PRIM-EDV/trx-tracker/parts/parts.xlsx

Part | Quantity | Price
E22900M30S | 1 | 10.87 €
