PRIM-EDV/trx-tracker/eagle/trx-breakout.brd

## EAGLE design eagle/trx-breakout.brd (2024-02-08)

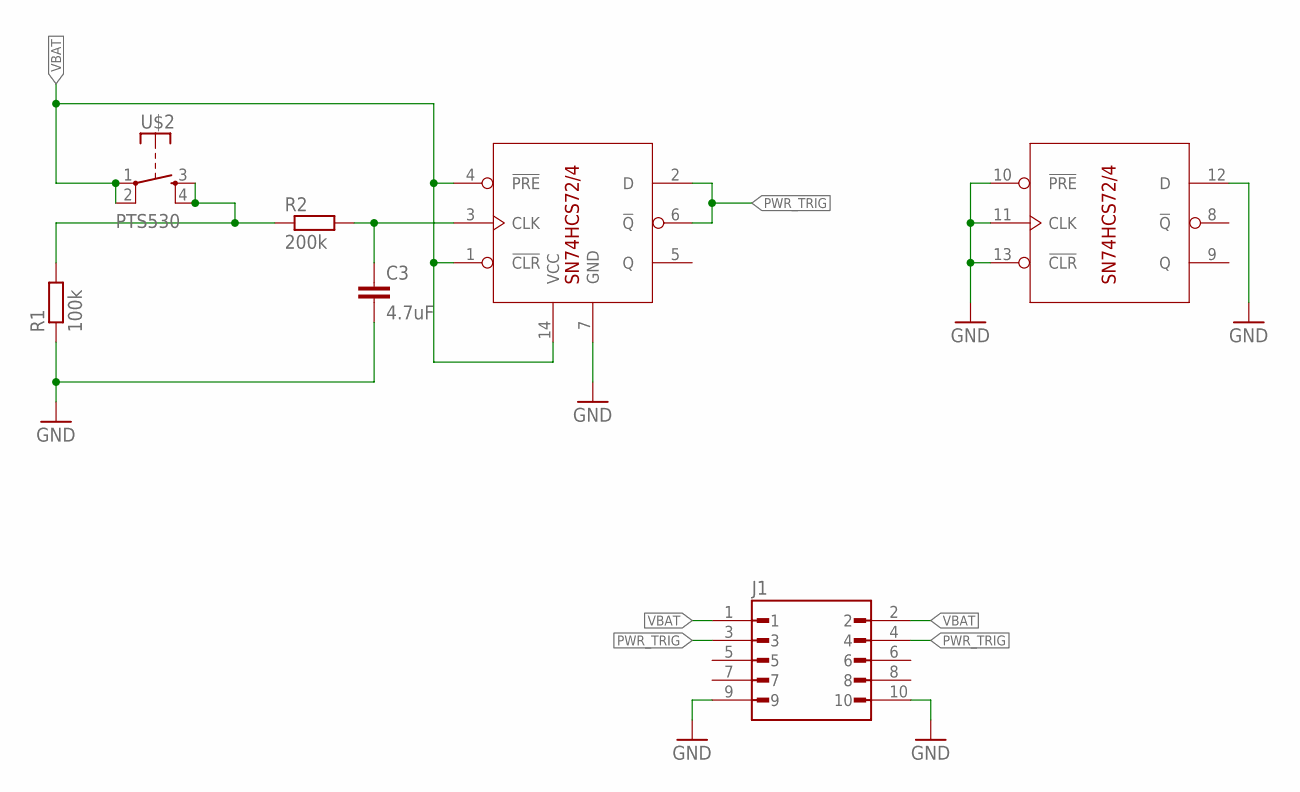
[picture p1: schematic trx-breakout.sch]

Parts:
C3: 4.7uF; C0805
J1: DF12NB(3.0)-10DX-0.5VHRS_DF12NB(3.0)-10DS-0.5V; HRS_DF12NB(3.0)-10DS-0.5V
R1: 100k; R0805
R2: 200k; R0805
U$1: SN74HCS72/4; TSSOP14
U$2: PTS530

Connections:
GND: C3.2, J1.9, J1.10, R1.1, U$1.7 (GND), U$1.10 (!PRE), U$1.11 (CLK), U$1.12 (D), U$1.13 (!CLR)
unnamed: C3.1, R2.2, U$1.3 (CLK)
unnamed: R1.2, R2.1, U$2.3 (S), U$2.4 (S)
PWR_TRIG: J1.3, J1.4, U$1.2 (D), U$1.6 (!Q)
VBAT: J1.1, J1.2, U$1.1 (!CLR), U$1.4 (!PRE), U$1.14 (VCC), U$2.1, U$2.2

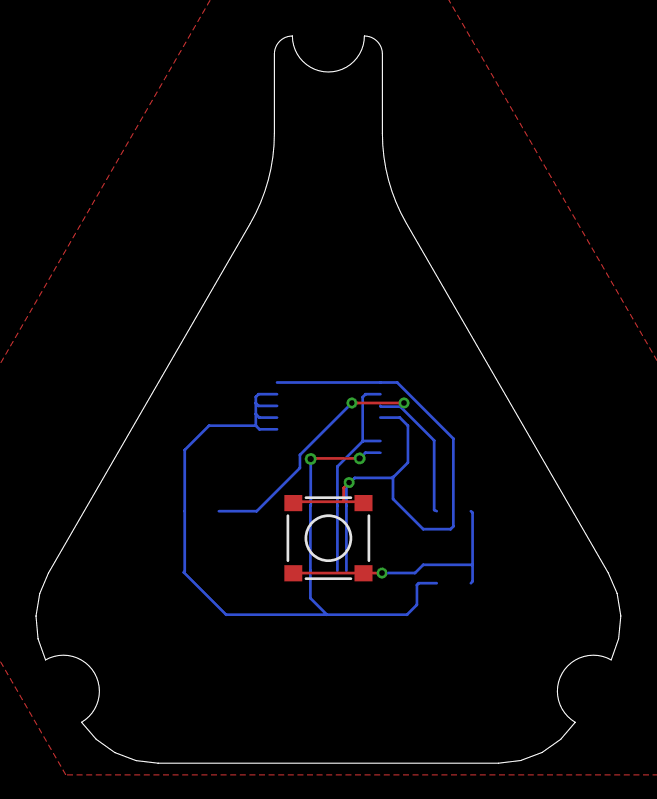
[picture p2: board trx-breakout.brd from above]

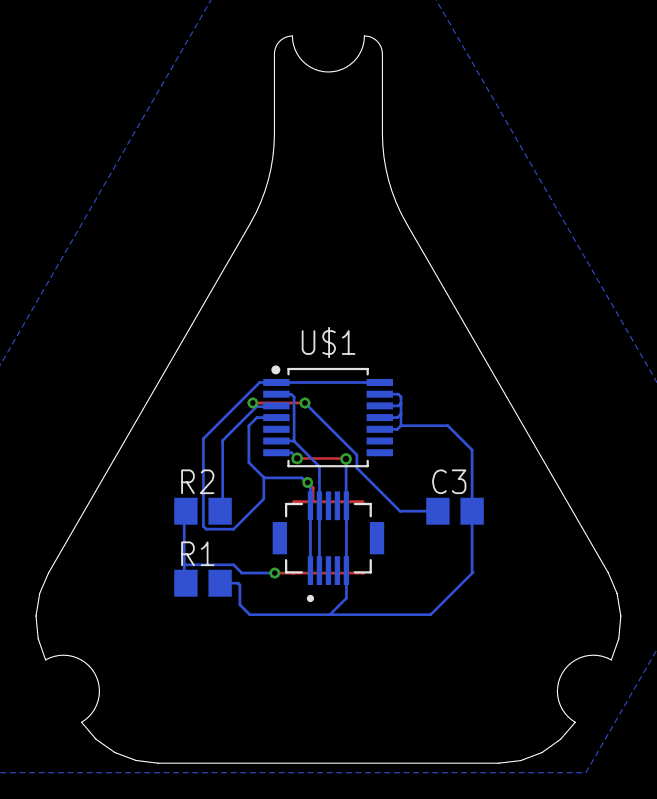
[picture p3: board trx-breakout.brd from below]

Board: 2 copper layers, 32.5 x 40.4 mm, 6 parts (5 on the bottom side), 5 nets.
