PRIM-EDV/trx-tracker/eagle/trx-mainboard.brd

## EAGLE design eagle/trx-mainboard.brd (2024-02-08)

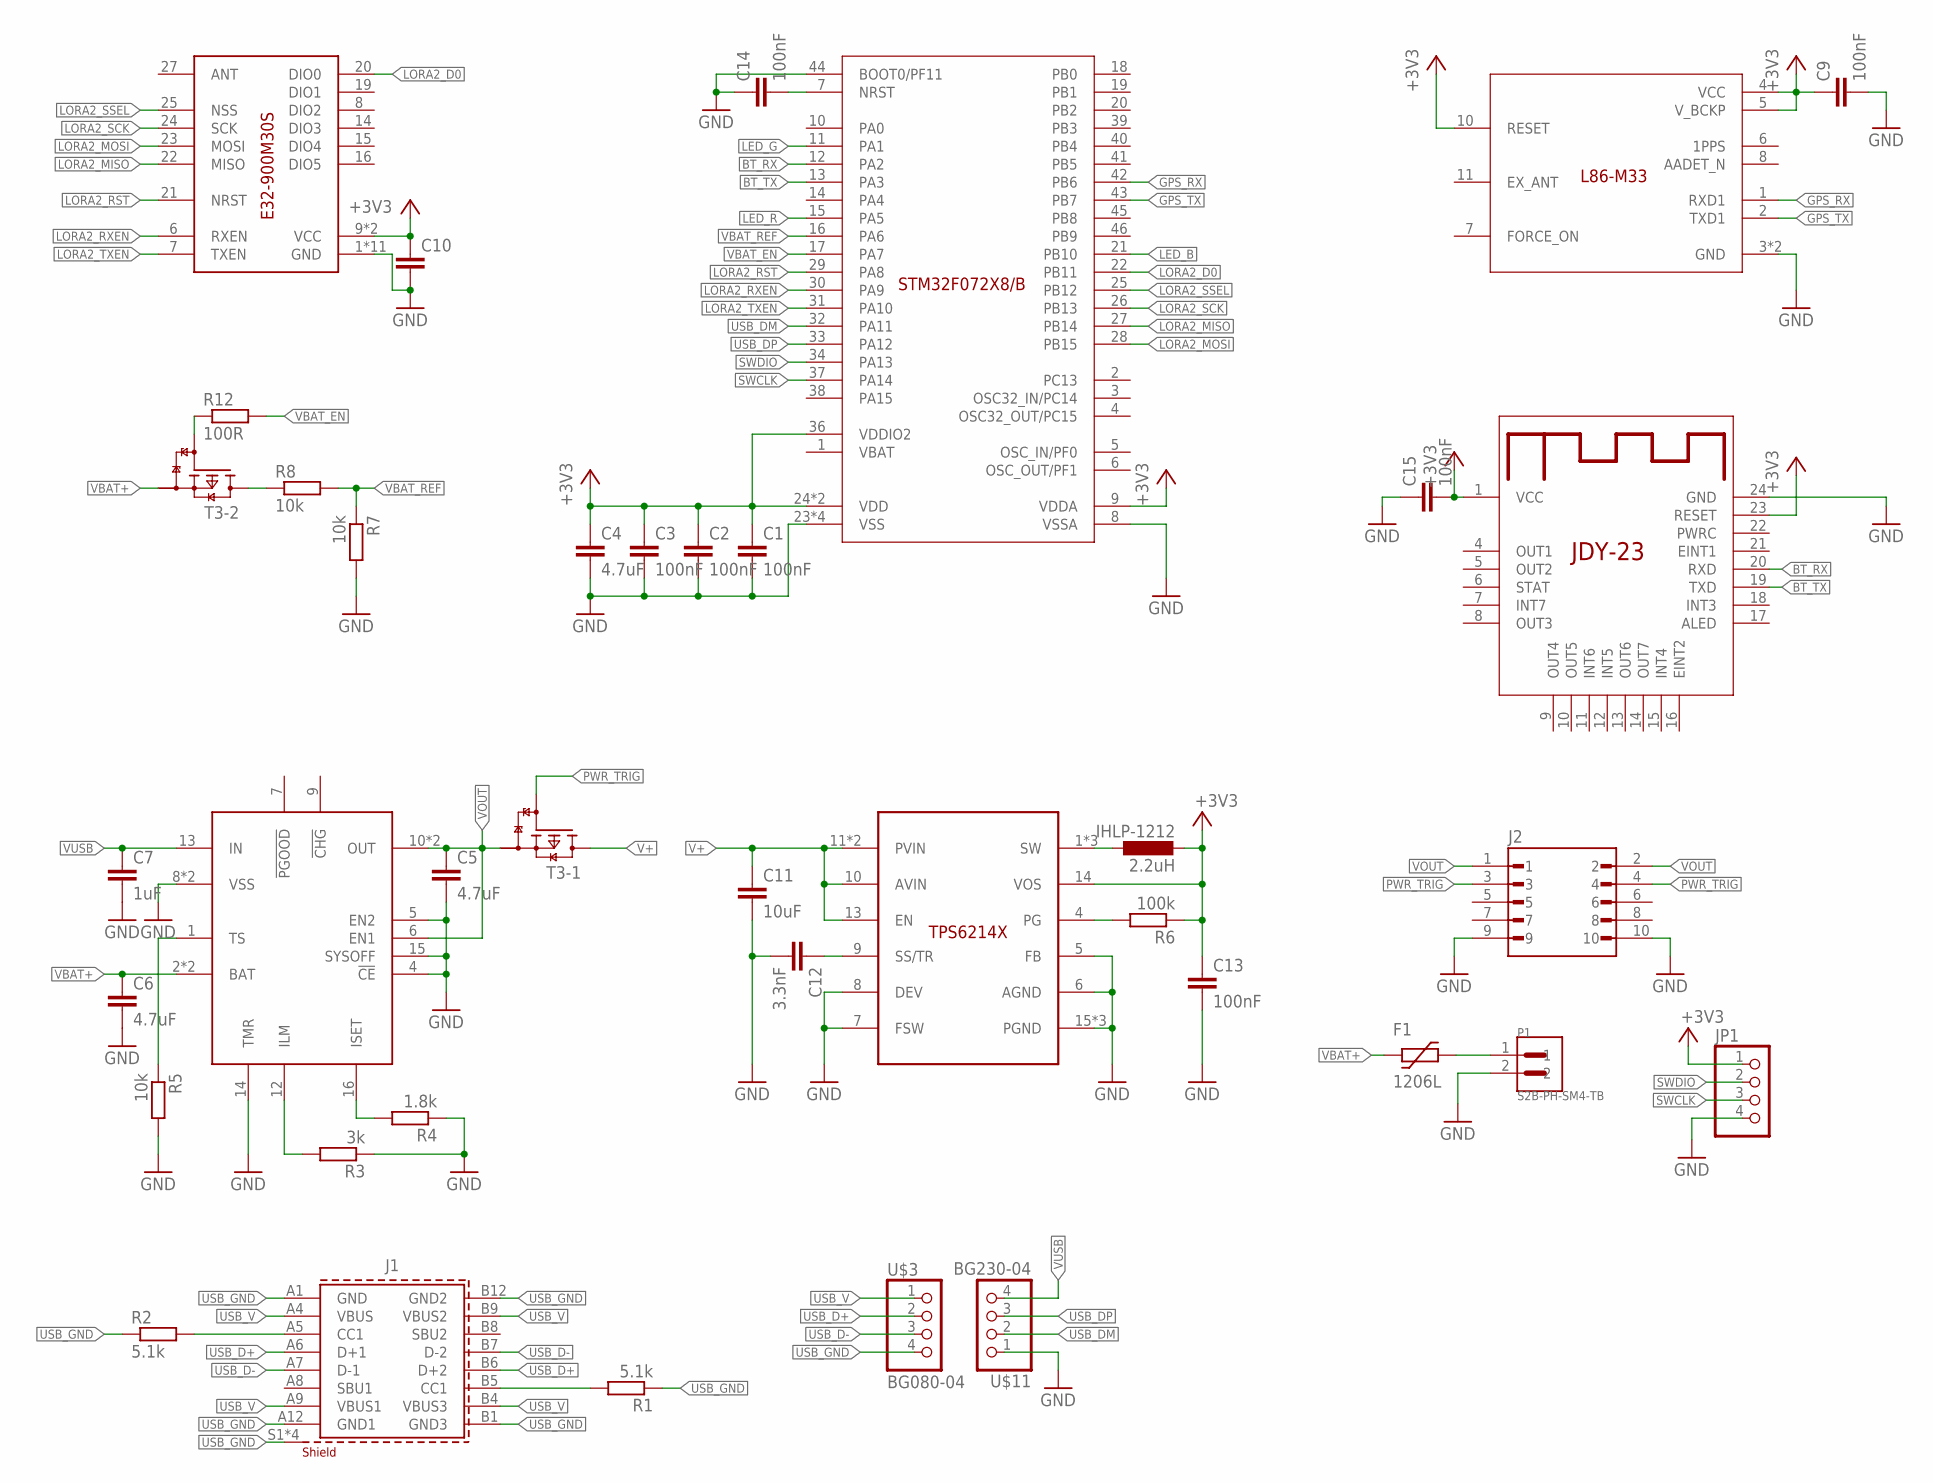
[picture p4: schematic trx-mainboard.sch, sheet 1, Logic]

Parts:
C1, C2, C3, C9, C13, C14, C15: 100nF; C0805
C4, C5, C6, C10: 4.7uF; C0805
C7: 1uF; C0805
C11: 10uF; C0805
C12: 3.3nF; C0805
F1: 1206L
J1: 629722000214
J2: DF12NB(3.0)-10DP-0.5V; HRS_DF12NB(3.0)-10DP-0.5V
JP1: PINHD-1X04_2.54-SMD; 1X04SMD
P1: S2B-PH-SM4-TB; JST_S2B-PH-SM4-TB
R1, R2: 5.1k; R0805
R3: 3k; R0805
R4: 1.8k; R0805
R5, R7, R8: 10k; R0805
R6: 100k; R0805
R12: 100R; R0805
T3: NX3008PBKS; SOT363
U2: BQ2407X; VQFN16-3X3
U$1: L86-M33
U$2: TPS6214X; VQFN16-3X3
U$3: BG080-04; P-1X4/90-2.54X1.50MMX2.54MM-SMT
U$4: IHLP-1212; 1212BZ
U$5: JDY-23
U$10: STM32-F072X8/B-48; UFQFPN48-7X7
U$11: BG230-04; S-1X4/90-2.54MM-SMT
U$14: E32-900M30S

Connections:
+3V3: C1.1, C2.1, C3.1, C4.1, C9.1, C10.1, C13.1, C15.2, JP1.1, R6.1, U$1.4 (VCC), U$1.5 (V_BCKP), U$1.10 (RESET), U$2.14 (VOS), U$4.2, U$5.1 (VCC), U$5.23 (RESET), U$10.9 (VDDA), U$10.24 (VDD), U$10.36 (VDDIO2), U$10.48 (VDD), U$14.9 (VCC), U$14.10 (VCC); also elsewhere on the board
BT_RX: U$5.20 (RXD), U$10.12 (PA2)
BT_TX: U$5.19 (TXD), U$10.13 (PA3)
GND: C1.2, C2.2, C3.2, C4.2, C5.2, C6.2, C7.2, C9.2, C10.2, C11.2, C12.2, C13.2, C14.1, C15.1, J2.9, J2.10, JP1.4, P1.2, R3.1, R4.1, R5.2, R7.2, U2.4 (!CE), U2.5 (EN2), U2.8 (VSS), U2.14 (TMR), U2.15 (SYSOFF), U2.17 (VSS), U$1.3 (GND), U$1.12 (GND), U$2.5 (FB), U$2.6 (AGND), U$2.7 (FSW), U$2.8 (DEV), U$2.15 (PGND), U$2.16 (PGND), U$2.17 (PGND), U$5.24 (GND), U$10.8 (VSSA), U$10.23 (VSS), U$10.35 (VSS), U$10.44 (BOOT0/PF11), U$10.47 (VSS), U$10.P$49 (VSS), U$11.1, U$14.1 (GND), U$14.2 (GND), U$14.3 (GND), U$14.4 (GND), U$14.5 (GND), U$14.11 (GND), U$14.12 (GND), U$14.17 (GND), U$14.18 (GND), U$14.26 (GND), U$14.28 (GND); also elsewhere on the board
GPS_RX: U$1.1 (RXD1), U$10.42 (PB6)
GPS_TX: U$1.2 (TXD1), U$10.43 (PB7)
LED_B: U$10.21 (PB10); also elsewhere on the board
LED_G: U$10.11 (PA1); also elsewhere on the board
LED_R: U$10.15 (PA5); also elsewhere on the board
LORA2_D0: U$10.22 (PB11), U$14.20 (DIO0)
LORA2_MISO: U$10.27 (PB14), U$14.22 (MISO)
LORA2_MOSI: U$10.28 (PB15), U$14.23 (MOSI)
LORA2_RST: U$10.29 (PA8), U$14.21 (NRST)
LORA2_RXEN: U$10.30 (PA9), U$14.6 (RXEN)
LORA2_SCK: U$10.26 (PB13), U$14.24 (SCK)
LORA2_SSEL: U$10.25 (PB12), U$14.25 (NSS)
LORA2_TXEN: U$10.31 (PA10), U$14.7 (TXEN)
unnamed: J1.A5 (CC1), R2.2
unnamed: J1.B5 (CC1), R1.2
unnamed: R3.2, U2.12 (ILM)
unnamed: R4.2, U2.16 (ISET)
unnamed: R5.1, U2.1 (TS)
unnamed: U$2.1 (SW), U$2.2 (SW), U$2.3 (SW), U$4.1
unnamed: C12.1, U$2.9 (SS/TR)
unnamed: R6.2, U$2.4 (PG)
unnamed: C14.2, U$10.7 (NRST)
unnamed: F1.P$2 (2), P1.1
unnamed: R8.1, T3.3 (D)
unnamed: R12.1, T3.5 (G)
PWR_TRIG: J2.3, J2.4, T3.2 (G)
SWCLK: JP1.3, U$10.37 (PA14)
SWDIO: JP1.2, U$10.34 (PA13)
USB_D+: J1.A6 (D+1), J1.B6 (D+2), U$3.2
USB_D-: J1.A7 (D-1), J1.B7 (D-2), U$3.3
USB_DM: U$10.32 (PA11), U$11.2
USB_DP: U$10.33 (PA12), U$11.3
USB_GND: J1.A1 (GND), J1.A12 (GND1), J1.B1 (GND3), J1.B12 (GND2), J1.S1 (SHIELD), J1.S2 (SHIELD), J1.S3 (SHIELD), J1.S4 (SHIELD), R1.1, R2.1, U$3.4
USB_V: J1.A4 (VBUS), J1.A9 (VBUS1), J1.B4 (VBUS3), J1.B9 (VBUS2), U$3.1
V+: C11.1, T3.6 (D), U$2.10 (AVIN), U$2.11 (PVIN), U$2.12 (PVIN), U$2.13 (EN)
VBAT+: C6.1, F1.P$1 (1), T3.4 (S), U2.2 (BAT), U2.3 (BAT)
VBAT_EN: R12.2, U$10.17 (PA7)
VBAT_REF: R7.1, R8.2, U$10.16 (PA6)
VOUT: C5.1, J2.1, J2.2, T3.1 (S), U2.6 (EN1), U2.10 (OUT), U2.11 (OUT)
VUSB: C7.1, U2.13 (IN), U$11.4

Notes on the sheet:
2.2uH

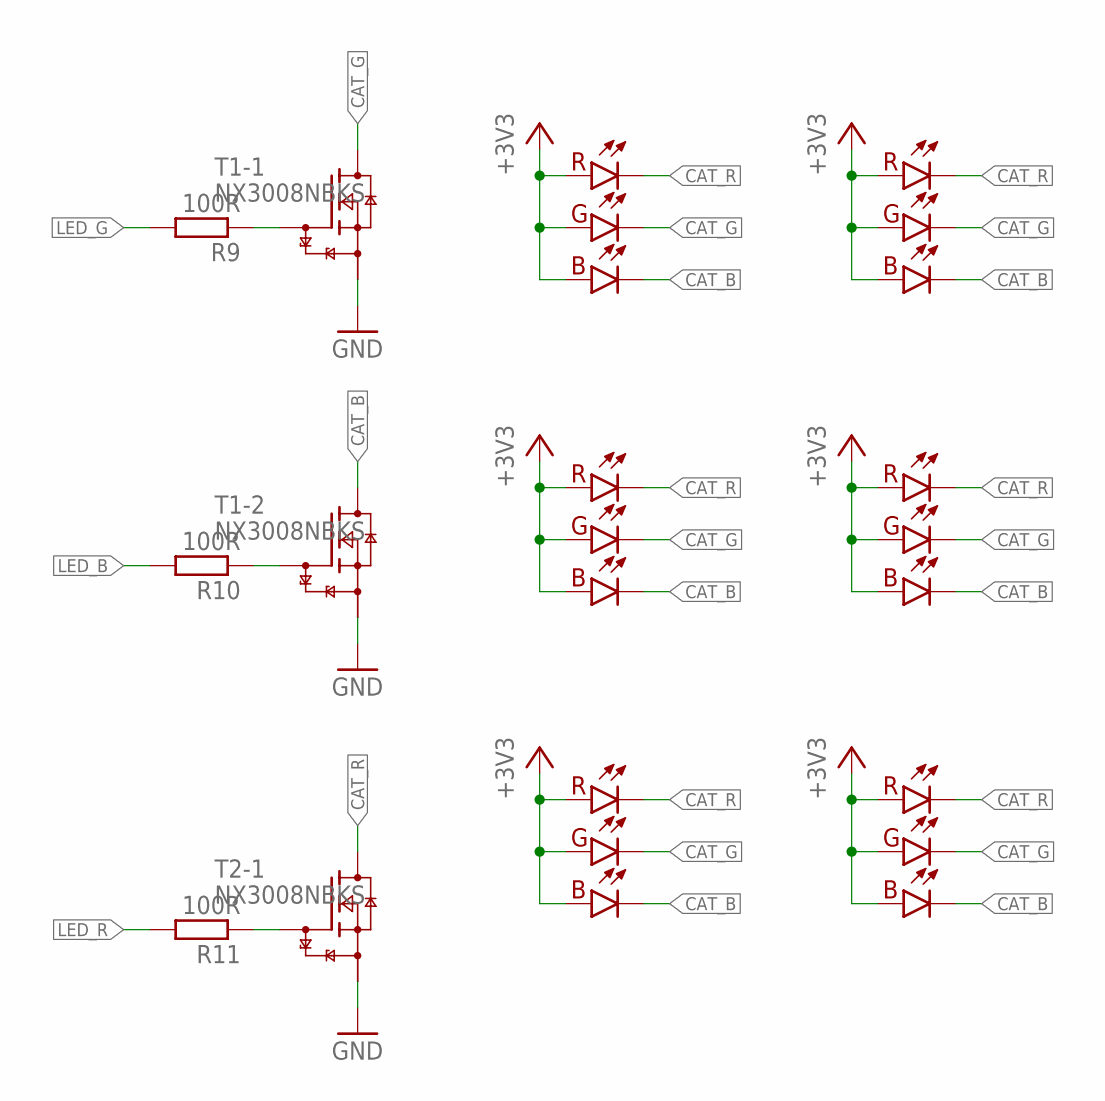
[picture p5: schematic trx-mainboard.sch, sheet 2]

Parts:
R9, R10, R11: 100R; R0805
T1, T2: NX3008NBKS; SOT363
U$6, U$7, U$8, U$9, U$12, U$13: RGB_LED; PLCC6

Connections:
+3V3: U$6.1 (A.B), U$6.3 (A.R), U$6.5 (A.G), U$7.1 (A.B), U$7.3 (A.R), U$7.5 (A.G), U$8.1 (A.B), U$8.3 (A.R), U$8.5 (A.G), U$9.1 (A.B), U$9.3 (A.R), U$9.5 (A.G), U$12.1 (A.B), U$12.3 (A.R), U$12.5 (A.G), U$13.1 (A.B), U$13.3 (A.R), U$13.5 (A.G); also elsewhere on the board
CAT_B: T1.3 (D), U$6.2 (C.B), U$7.2 (C.B), U$8.2 (C.B), U$9.2 (C.B), U$12.2 (C.B), U$13.2 (C.B)
CAT_G: T1.6 (D), U$6.6 (C.G), U$7.6 (C.G), U$8.6 (C.G), U$9.6 (C.G), U$12.6 (C.G), U$13.6 (C.G)
CAT_R: T2.6 (D), U$6.4 (C.R), U$7.4 (C.R), U$8.4 (C.R), U$9.4 (C.R), U$12.4 (C.R), U$13.4 (C.R)
GND: T1.1 (S), T1.4 (S), T2.1 (S); also elsewhere on the board
LED_B: R10.2; also elsewhere on the board
LED_G: R9.2; also elsewhere on the board
LED_R: R11.2; also elsewhere on the board
unnamed: R9.1, T1.2 (G)
unnamed: R10.1, T1.5 (G)
unnamed: R11.1, T2.2 (G)

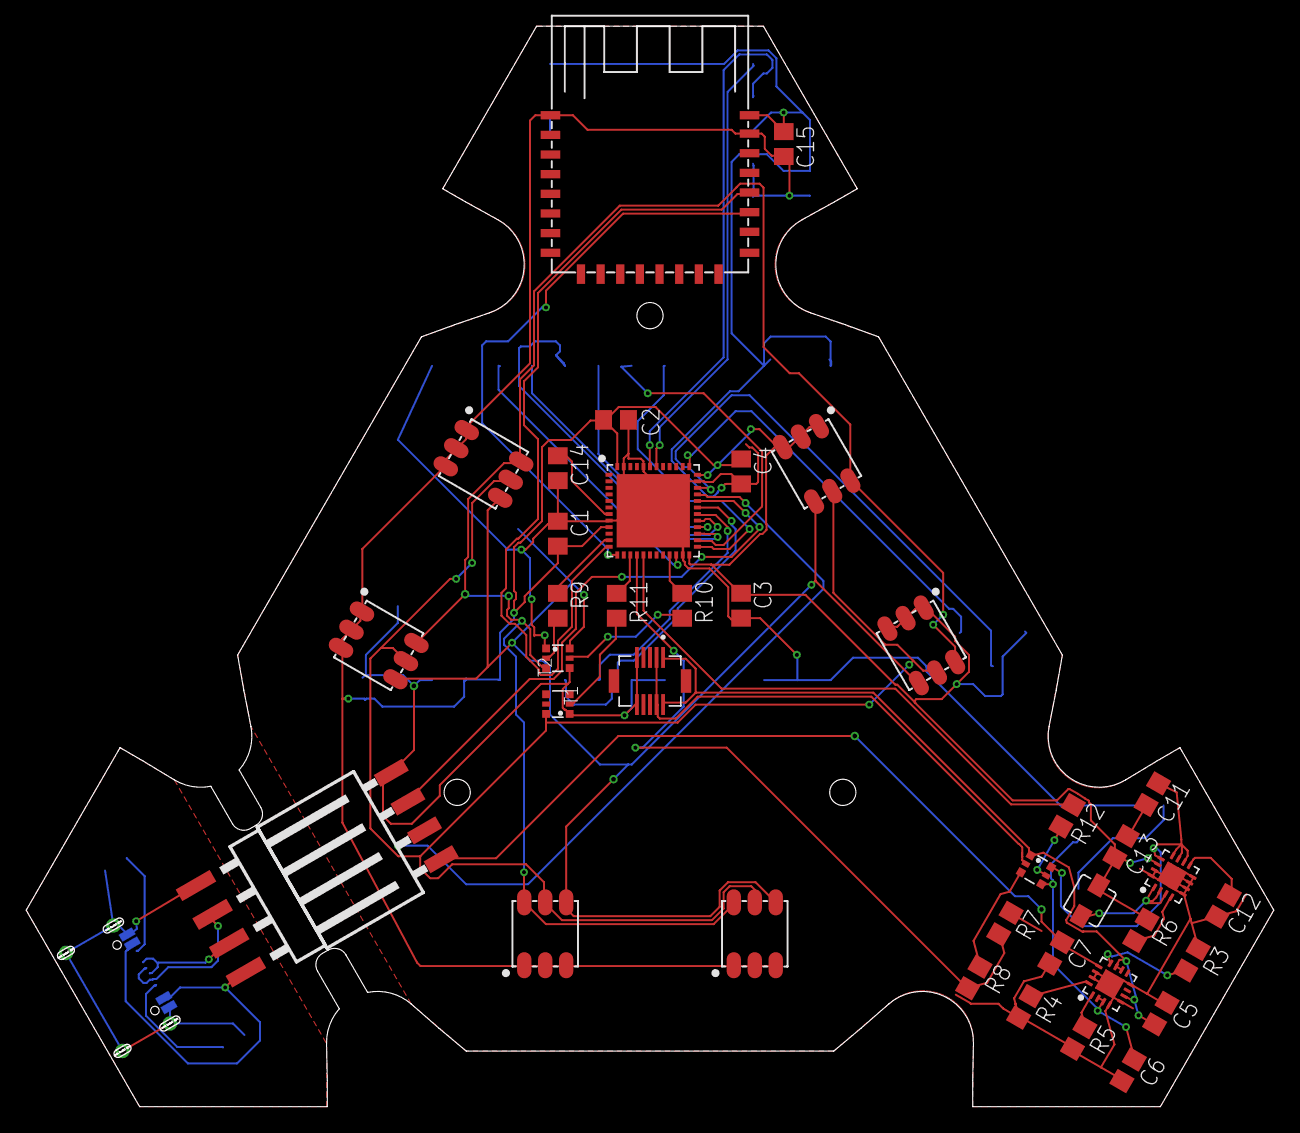
[picture p6: board trx-mainboard.brd from above]

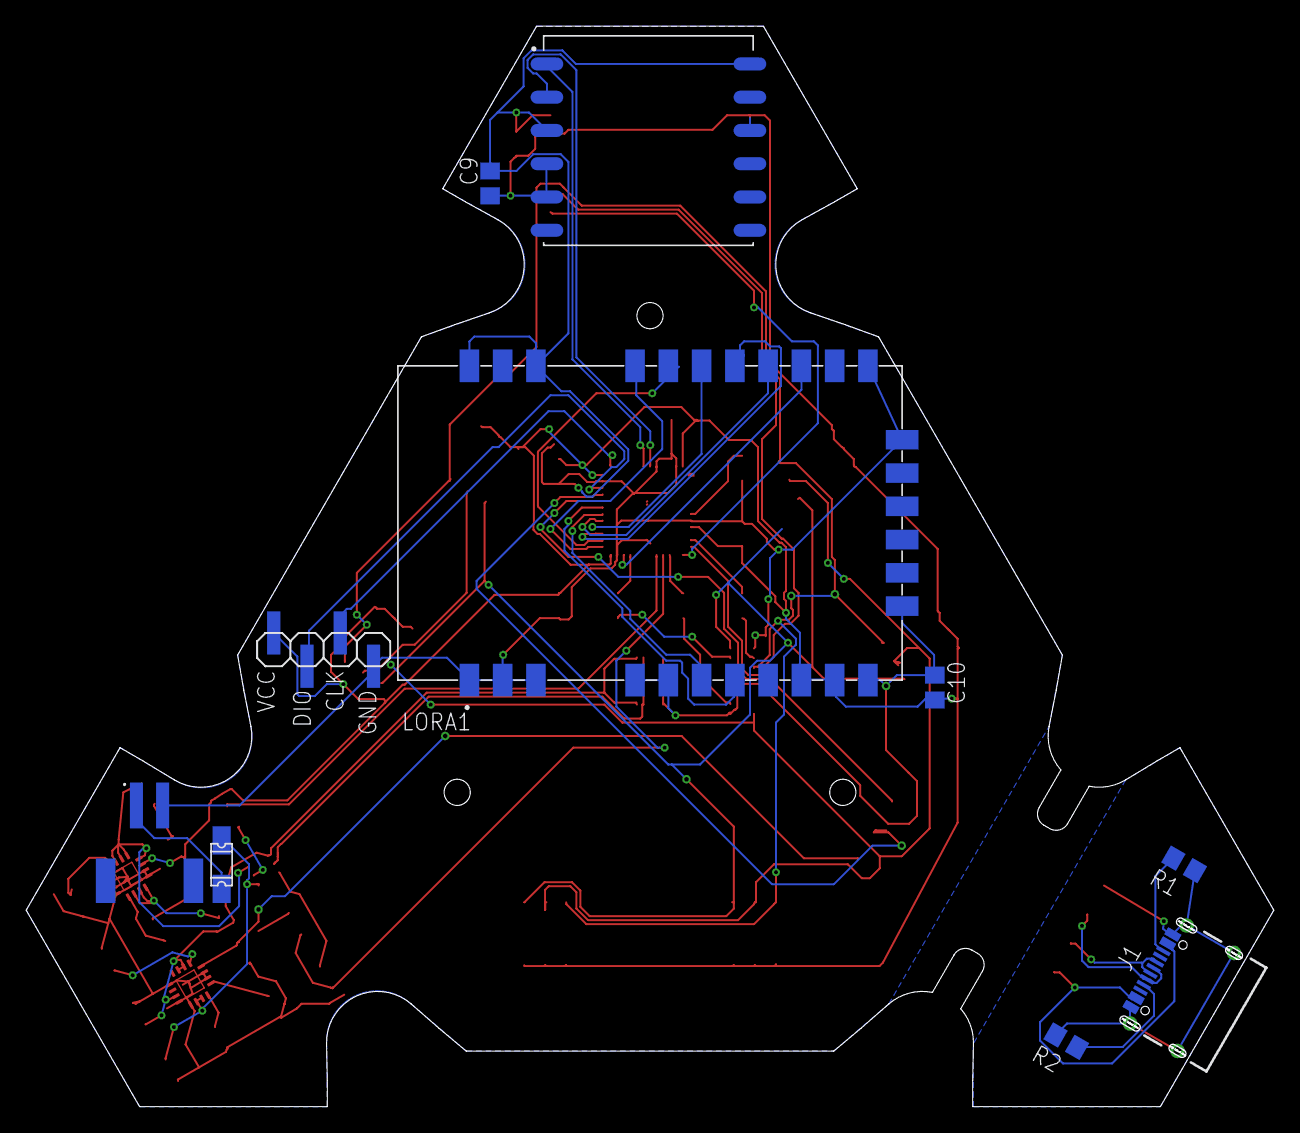
[picture p7: board trx-mainboard.brd from below]

Board: 2 copper layers, 95.3 x 82.5 mm, 49 parts (10 on the bottom side), 50 nets.
