PRIM-EDV/trx-tracker/(commit log)

2022-09-17 Added initial dat
    [trx-mainboard.brd, trx-mainboard.sch]
2023-05-01 Added eagle files and gitignore
    [trx-mainboard.brd, trx-mainboard.sch]
2023-05-01 Added display pinheader
    [trx-mainboard.brd, trx-mainboard.sch]
2023-05-02 Changed board layout
    [trx-mainboard.brd]
2023-05-08 Added further components to pcb
    [parts.xlsx, trx-mainboard.brd, trx-mainboard.sch]
2023-07-02 Added breakout board and progressed mainboard
    [trx-breakout.brd, trx-breakout.sch, trx-mainboard.brd]
2023-07-04 Added basic auto-route
    [trx-breakout.brd, trx-breakout.sch, trx-mainboard.brd, trx-mainboard.sch]
2023-07-16 Finalized alpha design
    [trx-breakout.brd, trx-breakout.sch, trx-mainboard.brd, trx-mainboard.sch]
2023-08-17 Added new layout and gerber files
    [trx-breakout.GBL, trx-breakout.GBO, trx-breakout.GBP, trx-breakout.GBS, trx-breakout.GTL, trx-breakout.GTO, trx-breakout.GTP, trx-breakout.GTS]
2023-08-25 Designed new boards wit fixed errors
    [trx-breakout.GBL, trx-breakout.GBO, trx-breakout.GBP, trx-breakout.GBS, trx-breakout.GTL, trx-breakout.GTO, trx-breakout.GTP, trx-breakout.GTS]
2023-09-21 Reworked breakout board
    [trx-breakout.brd, trx-breakout.sch]
2024-02-08 Modified board layout
    [trx-breakout.brd, trx-breakout.sch, trx-mainboard.brd, trx-mainboard.sch]
2024-03-26 Fixed Pin Settings and power control of E32 module
    [board.hpp]
2024-05-04 Added nanopb protocol boilerplate and led driver boilerplate
2024-05-05 Added preliminary led driver
2025-08-02 Added missing DIO mapping for CAD mode
2025-08-02 Added preliminary battery adc
2025-08-25 Added adc conversion for battery monitoring
